GandalfDG/ProMacroPad/(threads)

Thread 3 (2022-02-23):

Simultaneous keypresses in the same row do not register

GandalfDG, 2022-02-23:
the matrix_keypad.c driver in the linux kernel tree doesn't poll the keypad, it only scans the matrix after a row gpio interrupt occurs. If one key is held down, another key in the same row will not produce another interrupt.

GandalfDG, 2022-04-02:
Fixed with the updated matrix_keypad driver mainlined in #4

Closed 2022-04-02.

Thread 5 (2022-04-02):

Unknown IOCTL Kernel Messages

GandalfDG, 2022-04-02:
After more investigation, this isn't related to the updated matrix_keypad driver, but happens with the mainline kernel one as well. This leads me to believe it's an issue within the python frontend somewhere rather than being driver related. Need to track down what erroneous syscalls are happening when keys are pressed.
