GandalfDG/ProMacroPad/electronics/ProMacroPad_circuitry.kicad_sch

## KiCad design electronics/ProMacroPad_circuitry.kicad_sch (2022-02-23)

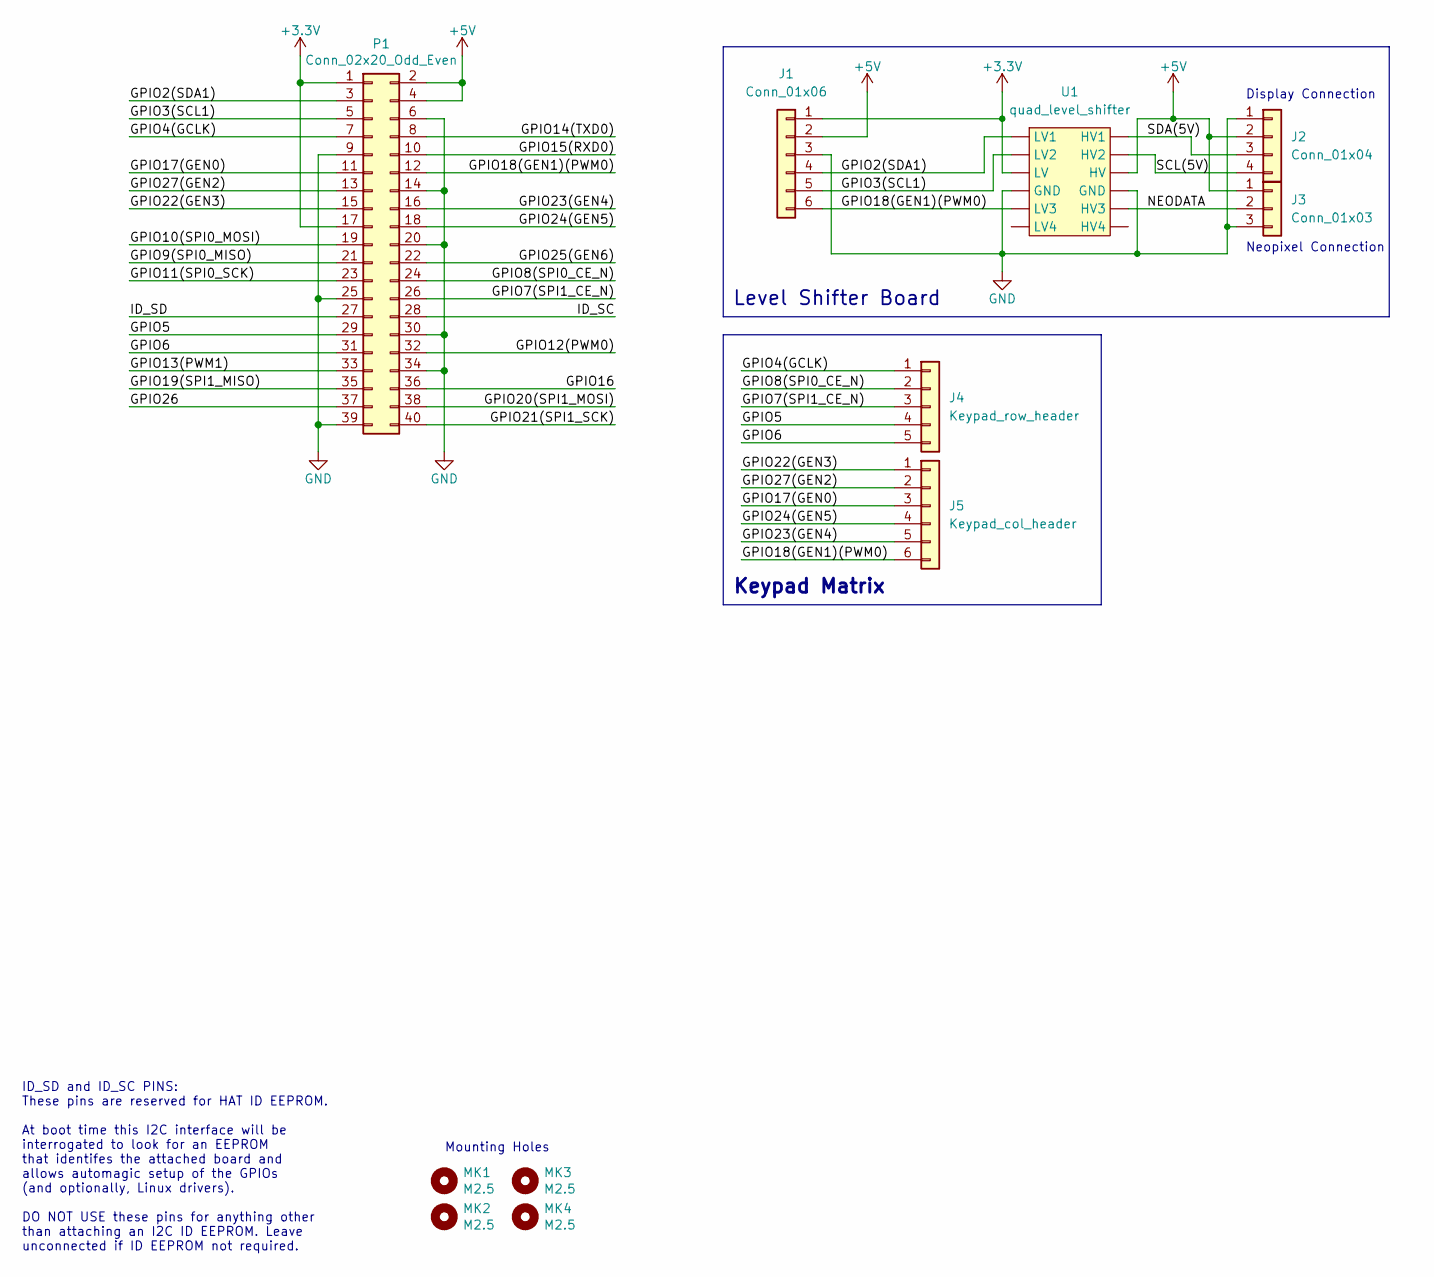
[picture p1: schematic ProMacroPad_circuitry.kicad_sch]

Parts:
J1: Conn_01x06; PinHeader_1x06_P2.54mm_Vertical
J2: Conn_01x04; PinHeader_1x04_P2.54mm_Vertical
J3: Conn_01x03; PinHeader_1x03_P2.54mm_Vertical
J4: Keypad_row_header; PinHeader_1x05_P2.54mm_Horizontal
J5: Keypad_col_header; PinHeader_1x06_P2.54mm_Horizontal
MK1, MK2, MK3, MK4: M2.5; MountingHole_2.7mm_M2.5
P1: Conn_02x20_Odd_Even; PinSocket_2x20_P2.54mm_Vertical
U1: quad_level_shifter

Connections:
+3.3V: J1.1, P1.1, P1.17, U1.
+5V: J1.2, J2.2, J3.1, P1.2, P1.4, U1.
GND: J1.3, J2.1, J3.3, P1.6, P1.9, P1.14, P1.20, P1.25, P1.30, P1.34, P1.39, U1.
GPIO2(SDA1): J1.4, P1.3, U1.
GPIO3(SCL1): J1.5, P1.5, U1.
GPIO4(GCLK): J4.1, P1.7
GPIO5: J4.4, P1.29
GPIO6: J4.5, P1.31
GPIO7(SPI1_CE_N): J4.3, P1.26
GPIO8(SPI0_CE_N): J4.2, P1.24
GPIO9(SPI0_MISO): P1.21
GPIO10(SPI0_MOSI): P1.19
GPIO11(SPI0_SCK): P1.23
GPIO12(PWM0): P1.32
GPIO13(PWM1): P1.33
GPIO14(TXD0): P1.8
GPIO15(RXD0): P1.10
GPIO16: P1.36
GPIO17(GEN0): J5.3, P1.11
GPIO18(GEN1)(PWM0): J1.6, J5.6, P1.12, U1.
GPIO19(SPI1_MISO): P1.35
GPIO20(SPI1_MOSI): P1.38
GPIO21(SPI1_SCK): P1.40
GPIO22(GEN3): J5.1, P1.15
GPIO23(GEN4): J5.5, P1.16
GPIO24(GEN5): J5.4, P1.18
GPIO25(GEN6): P1.22
GPIO26: P1.37
GPIO27(GEN2): J5.2, P1.13
ID_SC: P1.28
ID_SD: P1.27
NEODATA: J3.2, U1.
SCL(5V): J2.4, U1.
SDA(5V): J2.3, U1.

Notes on the sheet:
ID_SD and ID_SC PINS: These pins are reserved for HAT ID EEPROM. At boot time this I2C interface will be interrogated to look for an EEPROM that identifes the attached board and allows automagic setup of the GPIOs (and optionally, Linux drivers). DO NOT USE these pins for anything other than attach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
Mounting Holes
Display Connection
Keypad Matrix
Level Shifter Board
Neopixel Connection
