GandalfDG/ProMacroPad/(commit log)

2022-01-18 adding KiCad files
    [ProMacroPad_circuitry.kicad_pcb, ProMacroPad_circuitry.kicad_sch]
2022-01-19 Getting closer to a properly parametrized side panel polygon
    [ProMacroPad.scad]
2022-01-19 fixed trig for display portion of side panel polygon
    [ProMacroPad.scad]
2022-01-19 Removed includes from scad file for easy portability
    [ProMacroPad.scad]
2022-01-20 reorganizing repo
    [ProMacroPad.scad, ProMacroPad_circuitry.kicad_pcb, ProMacroPad_circuitry.kicad_sch]
2022-01-20 refining front edge of side polygon
    [ProMacroPad.scad]
2022-01-20 More reorganization
    [ProMacroPad.scad, ProMacroPad_circuitry.kicad_pcb, ProMacroPad_circuitry.kicad_sch]
2022-01-20 fixed missing parens on side polygon point calculation
    [ProMacroPad.scad]
2022-01-20 renamed overall_dimensions to overall_footprint and removed z dimension
    [ProMacroPad.scad]
2022-01-20 improved 2D tab module
    [ProMacroPad.scad]
2022-01-20 Split apart connectors for LCD and keypad neopixel strip in the schematic
    [ProMacroPad_circuitry.kicad_sch]
2022-01-21 added keypad matrix connectors to schematic
    [ProMacroPad_circuitry.kicad_sch]
2022-01-22 added some quick and dirty mounting holes for the pi zero and for two mini solderable breadboard PCBs
    [ProMacroPad.scad]
2022-01-22 commit of changes made for first laser-cut prototype
    [ProMacroPad.scad]
2022-01-22 Fill in CAD with dimensions of actual hardware (#1)
    * Beginning to put real dimensions into the case CAD.
    Keypad plate now corresponds to real PCB dimensions.
    * display cutout and mounting holes have been measured
    * display frame width is now equal to the keypad plate width
    not the most general solution, but the two main dimensionally
    important pieces are in a working state now.
    * making tweaks
    * ensure the display cutout offset is applied after translating it to
    its proper position
    * reorganizing and cleaning up measured values
    * more reorganization, scad file will by default generate 2d profiles for
    SVG export
    * fixed 3D mockup of CAD
    [ProMacroPad.scad]
2022-02-23 Devicetree for GPIO Matrix Keypad (#2)
    * created devicetree overlay file for the keypad
    * filled in row/col gpio numbers into dts
    file taken from: https://blog.geggus.net/2017/08/a-matrix-keypad-on-a-raspberry-pi-done-right/
    * setting gpio-activelow may be the tweak needed
    to get the keypad to behave
    Since the matrix has diodes, it only works one way
    * working devicetree and pin mapping for the keypad
2022-02-23 updated schematic with the GPIO assignments
    these are the GPIO assignments encoded in the device tree source
    file, and they are what is currently connected in the prototype.
    [ProMacroPad_circuitry.kicad_sch]
2022-02-26 end of file newlines 🤦‍♂️
2022-04-02 Keyboard driver (#4)
    Need to debug unknown IOCTL kernel messages, but it does what was intended.
    * initial commit of matrix_keypad driver
    Copied from kernel source
    needs to be modified to poll while any key is held down
    this will hopefully address issue #3
    * updated .gitignore for module compile artifacts
    * updated .gitignore for module compile artifacts
    * added makefile and fixed module_build.sh
    * updated comment header and module documentation macros
    * Added initial code to support polling of the keypad
    When a key is pressed triggering an interrupt, polling will be enabled.
    When scanning the keypad, if no keys are held, polling will be disabled.
    Untested.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
    [matrix_keypad.c]
2022-04-07 added LCD driver code to repo
2022-04-07 polling keypad driver can now be built and installed (#6)
    using DKMS
2022-04-07 added display driver dkms.conf
2022-04-07 removed lcd driver examples directory
2022-04-13 Update README.md for the lcd driver
    Added explicit attribution of the original module author's repository
